ReinhardLenz/compass-belt-seeeduino-XIAO/images/03_circuit_image.png

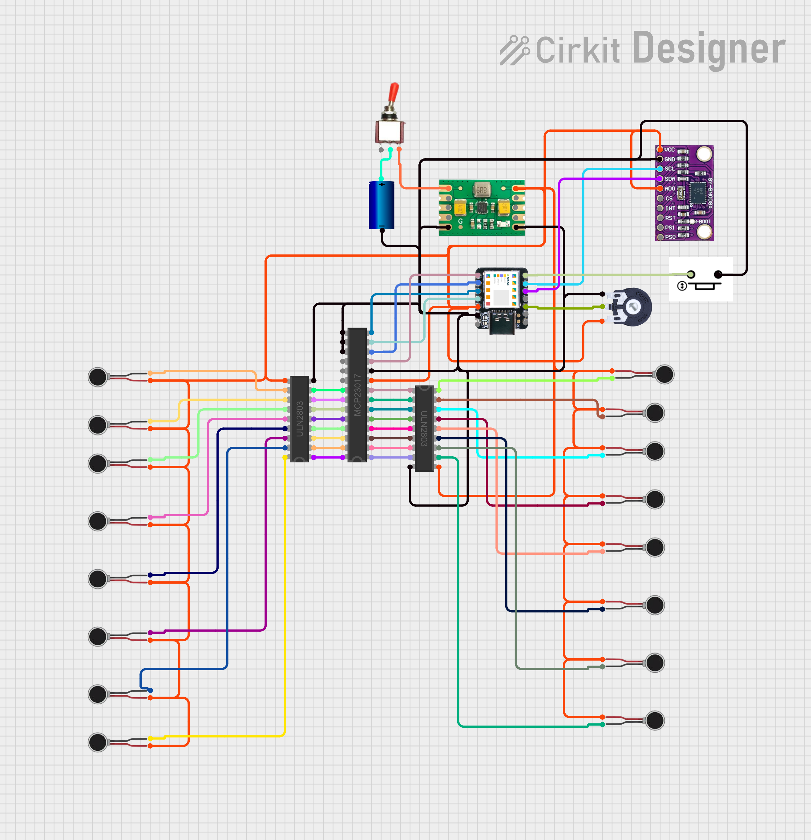
images/03_circuit_image.png
