ReinhardLenz/compass-belt-seeeduino-XIAO/images/03_circuit_imageA.png

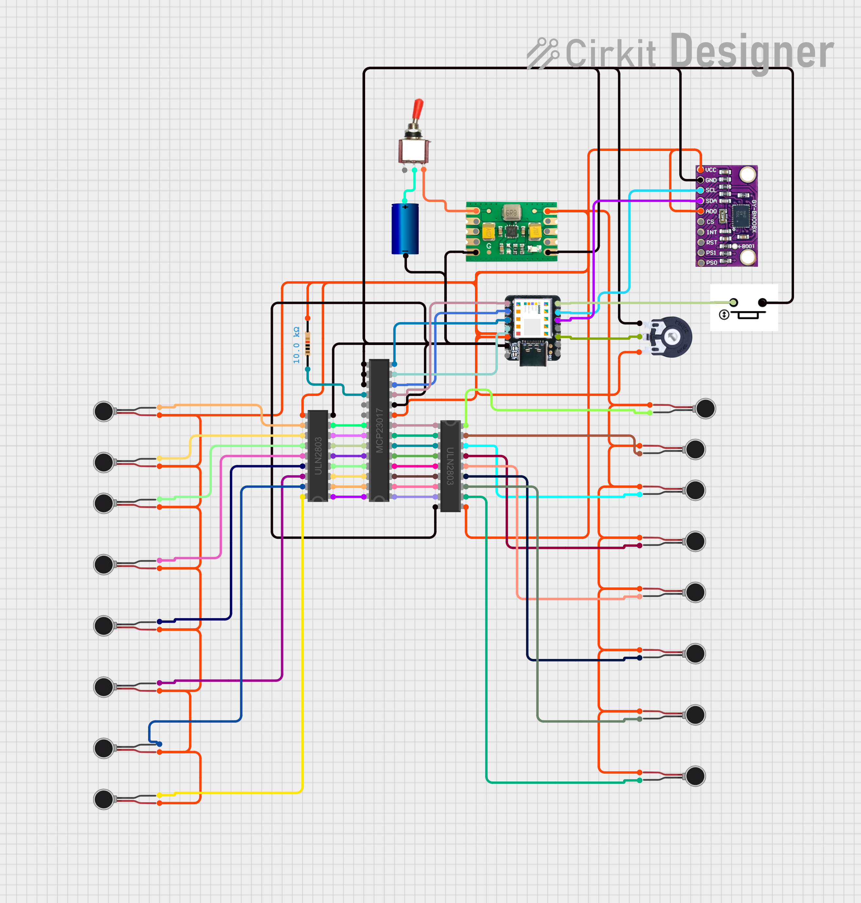
images/03_circuit_imageA.png
