ReinhardLenz/compass-belt-seeeduino-XIAO/images/PCB_PCB_Compass-belt-control_TPS63031_2026-11-052.png

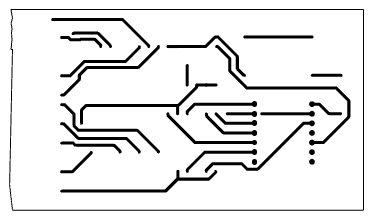
images/PCB_PCB_Compass-belt-control_TPS63031_2026-11-052.png
