ReinhardLenz/compass-belt-seeeduino-XIAO/images/SeeeduinoXIAO2d.png

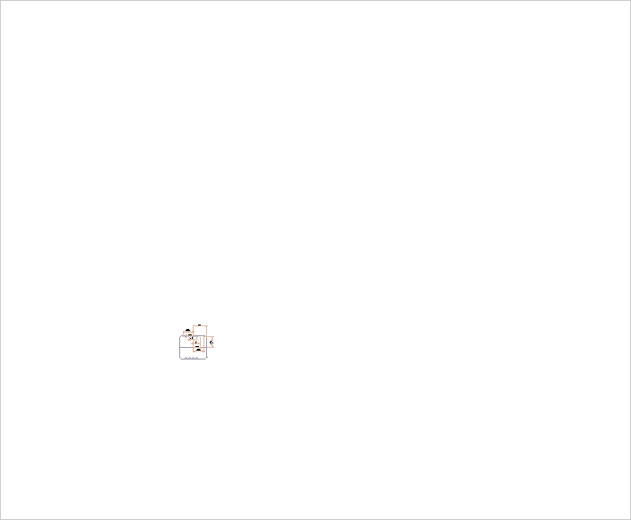
images/SeeeduinoXIAO2d.png
