ReinhardLenz/compass-belt-seeeduino-XIAO/images/PCB_Compass-belt-control_TPS63031_2026-11-05.dxf

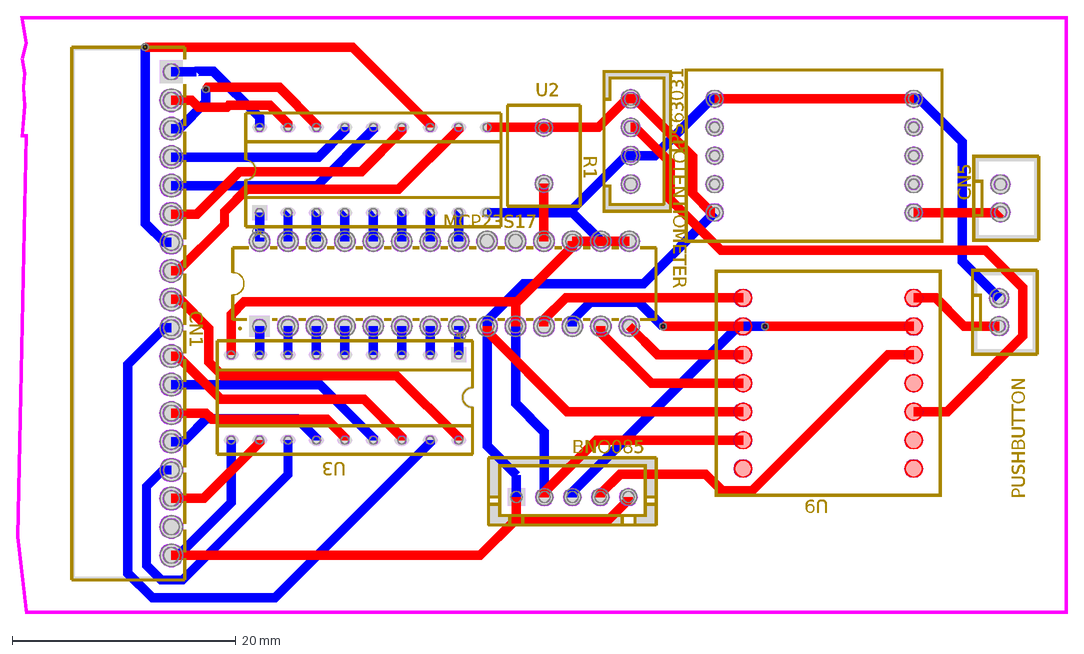
[picture p22: CAD file, 2026-11-06]
images/PCB_Compass-belt-control_TPS63031_2026-11-05.dxf
POTENTIOMETER
CN5
PUSHBUTTON
MCP23S17
R1
TPS63031
U2
U3
U9
BNO085
CN1
