ReinhardLenz/compass-belt-seeeduino-XIAO/images/OBJ_PCB_Compass belt control_TPS63031.obj

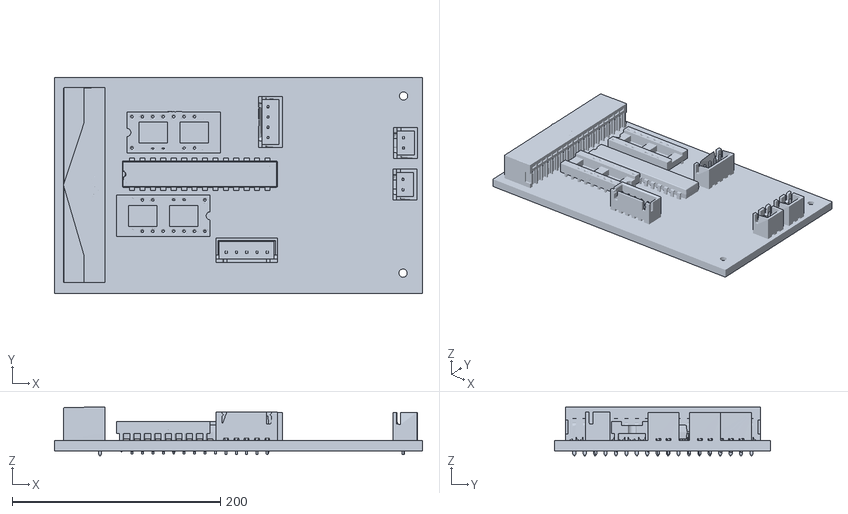
[picture p23: CAD file, 2026-11-06]
images/OBJ_PCB_Compass belt control_TPS63031.obj
353.1 x 207.5 x 46.9
