ReinhardLenz/compass-belt-seeeduino-XIAO/images/wire_scheme_1.pdf

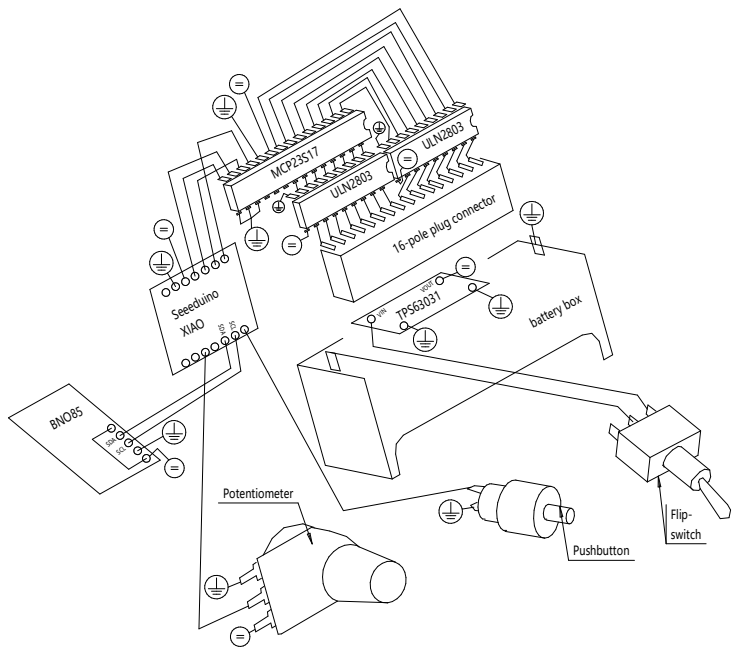
[picture p24: page 1]
BNO85; Seeeduino; XIAO; MCP23S17; ULN2803; Potentiometer; Pushbutton; TPS63031; Flip- switch; SCL VIN; VOUT SDA; SCL

16-pole plug connector

bat ery box SDA
