ReinhardLenz/compass-belt-seeeduino-XIAO/images/Schematic_Compass-belt-control_TPS63031_2026-11-06.pdf

## TO BNO085

## POTENTIOMETER

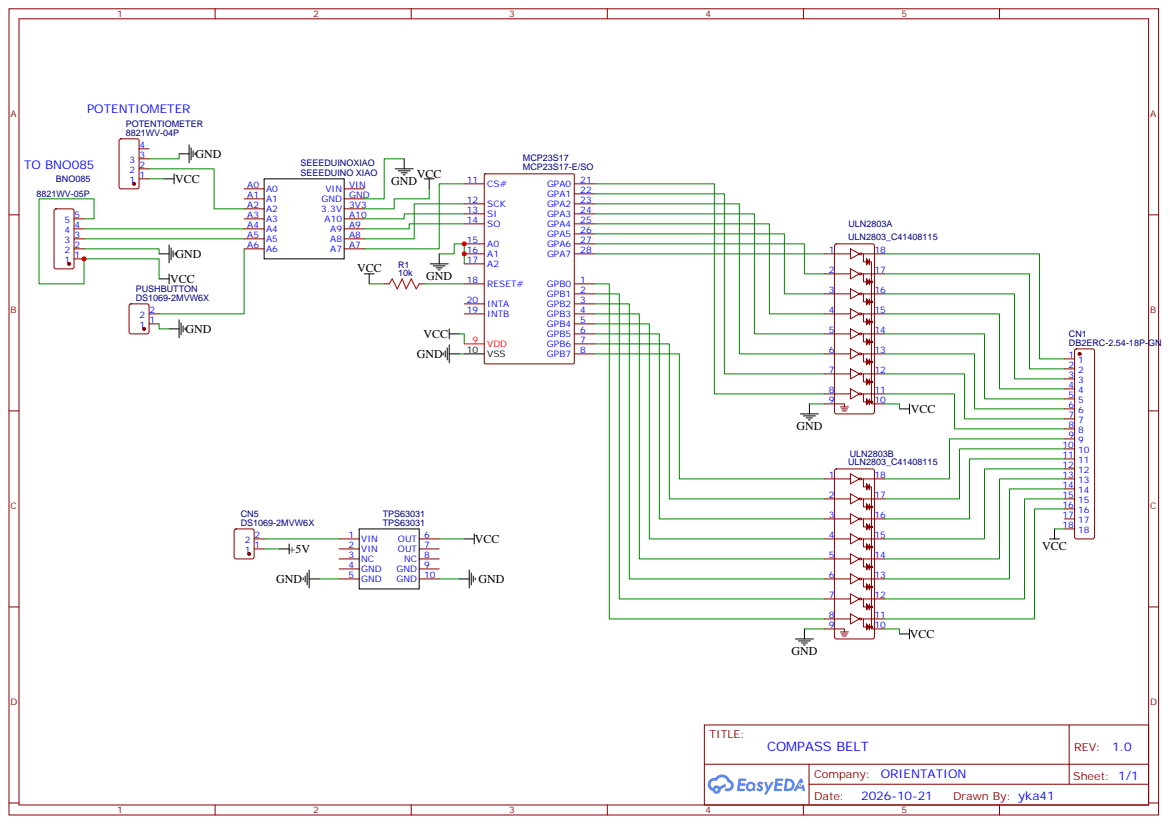
[picture p25: page 1]
