ReinhardLenz/compass-belt-seeeduino-XIAO/images/PCB_PCB_Compass-belt-control_TPS63031_2026-11-06.pdf

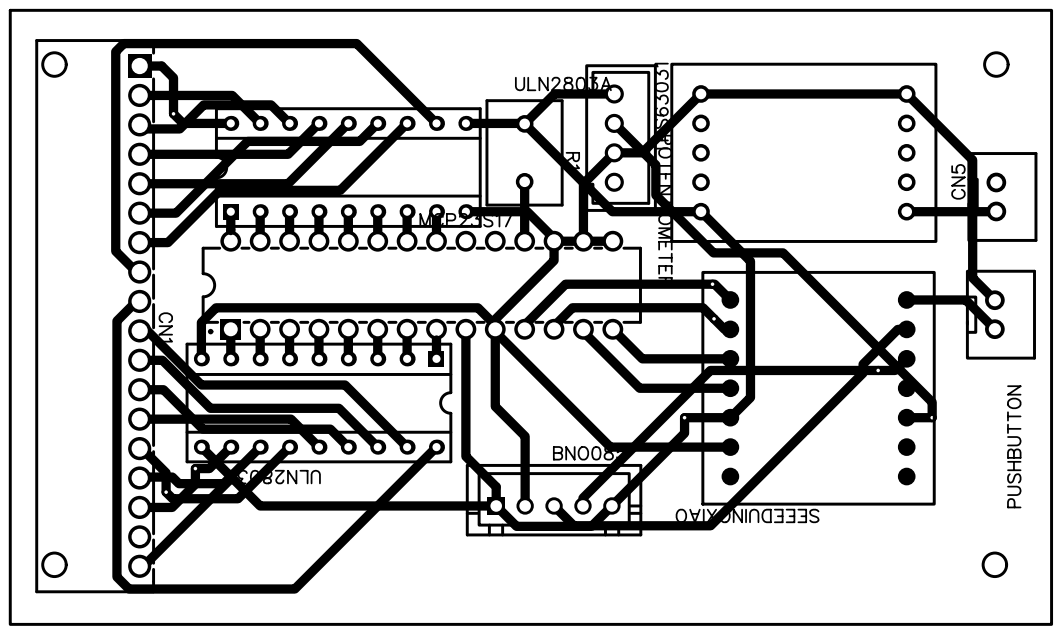
[picture p26: page 1]
