ReinhardLenz/compass-belt-seeeduino-XIAO/images/PCB_PCB_Compass-belt-control_TPS63031_2026-11-06 (1).pdf

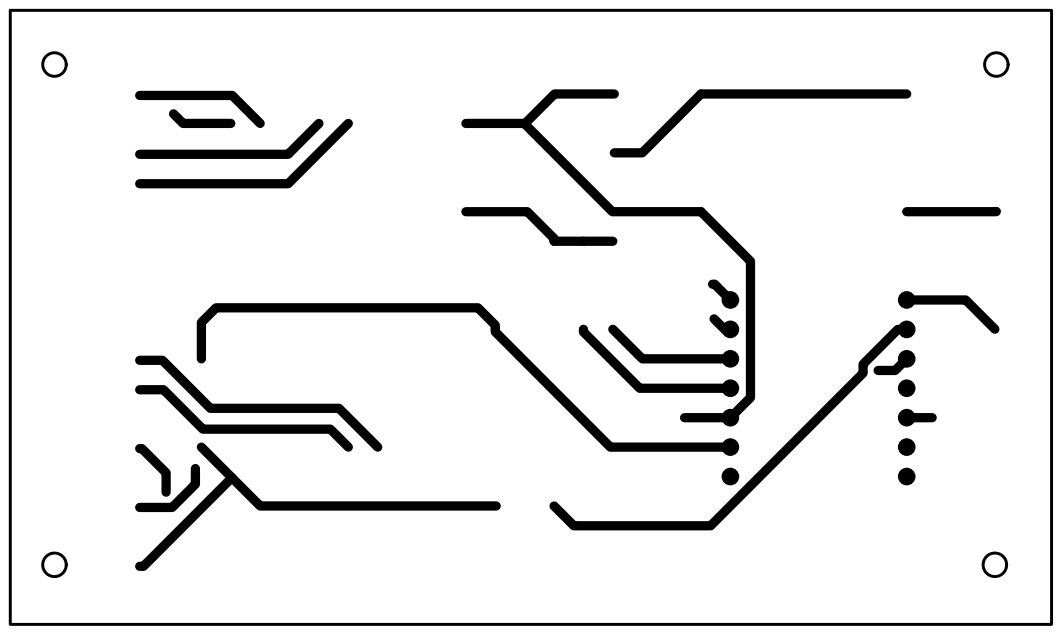
[picture p27: page 1]
