ReinhardLenz/compass-belt-seeeduino-XIAO/images/PCB_PCB_Compass-belt-control_TPS63031_2026-11-06 (2).pdf

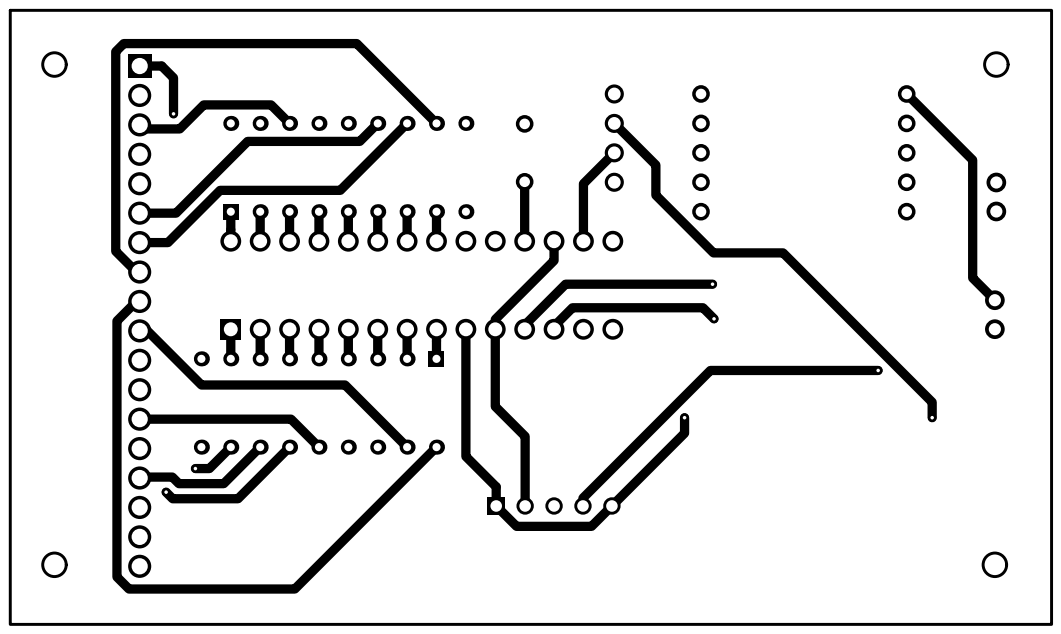
[picture p28: page 1]
