ReinhardLenz/compass-belt-seeeduino-XIAO/src/Button.cpp

#include "Button.h"
#include <Arduino.h>

Button* Button::instance = nullptr;

Button::Button(int pin, CompassBelt* compassBelt) : button(pin, true, false), compassBelt(compassBelt) {
    instance = this;
}

void Button::setup() {
    button.attachDoubleClick(doubleclick);
    button.attachClick(singleclick);
    button.attachLongPressStop(longclick);
    button.setDebounceMs(20);
    button.setClickMs(400);
    button.setPressMs(2000);
}

void Button::tick() {
    button.tick();
}

void Button::doubleclick() {
    instance->compassBelt->setAlwaysOn(!instance->compassBelt->isAlwaysOn());
    Serial.println("Double click");
    
}

void Button::singleclick() {
    instance->compassBelt->setNextVibrationInterval();
    Serial.println("Single click");

}

void Button::longclick() {
    instance->compassBelt->lampTest();
    Serial.println("long click");

}
