ReinhardLenz/compass-belt-seeeduino-XIAO/(commit log)

2026-02-17 Add README documentation for Compass Belt project
    Add detailed documentation for Compass Belt project, including overview, features, circuit documentation, wiring details, software overview, and usage instructions.
2026-03-03 switch added, TPS63031 added, revised diagram, all motors shown, 3.3V to motors (was 8V)
    Updated circuit documentation and component descriptions in README.md.
2026-03-03 Revise README for clarity on components and behavior
    Updated README to clarify circuit components and functionality.
2026-03-03 add pinout diagrams of components
    Updated component list with additional images and corrected pin details.
2026-03-09 Update README with compass belt details and images
    Added a new section for the compass belt and updated images.
2026-03-19 Update README with electronics box and wiring details
    Added sections for electronics box, 3D printable parts, and wiring scheme.
2026-04-20 Revise circuit diagrams and wiring details in README
    Updated images and wiring details for various components.
2026-04-21 image folder added, seeeduino XIAO pin A7 to pin CS MCP23S17 and 3.3V to MCP23S17 pin VDD
2026-04-28 added 10kohm resistor to MCP23S17 RESET pin and blinks to setup
2026-05-05 NX project added, updated stl part (the battery shutter improved
2026-11-06 new files , PCB related
2026-11-06 2nd commit Schematic
2026-11-11 2nd commit gerber file
2026-11-11 2nd commit gerber file 1
